Mathieu-py/autonomous-robot/cad/preview/option_b_preview.png

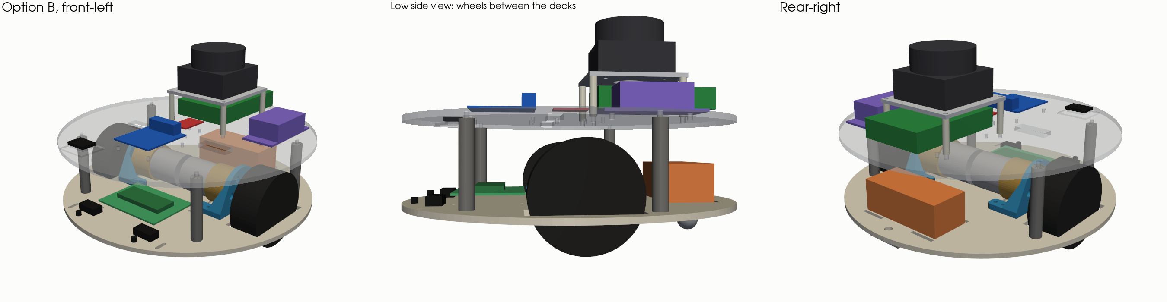
cad/preview/option_b_preview.png
