Mathieu-py/autonomous-robot/cad/preview/motor_mount_right.stl

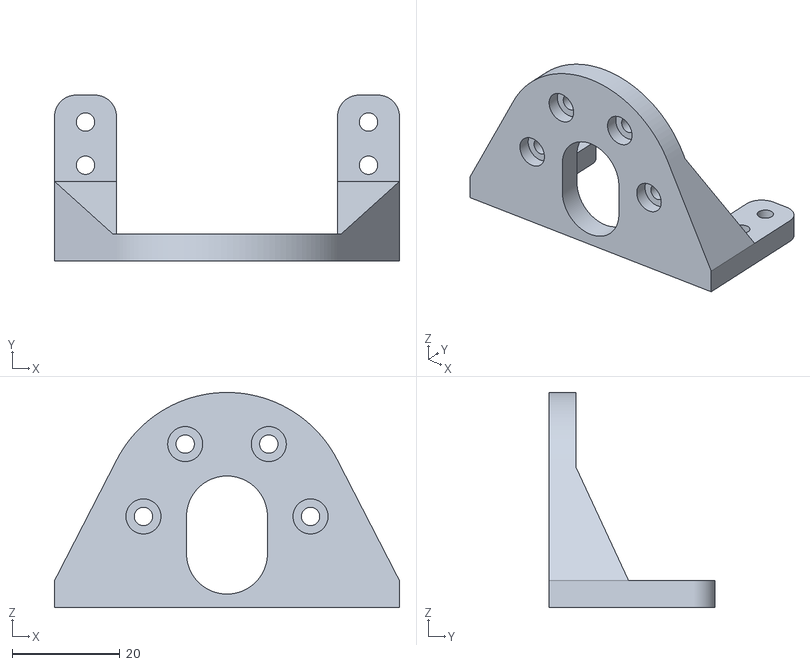
[picture p3: CAD file, 2026-11-11]
cad/preview/motor_mount_right.stl
64.0 x 30.8 x 39.9
