Mathieu-py/autonomous-robot/cad/preview/lower_deck.stl

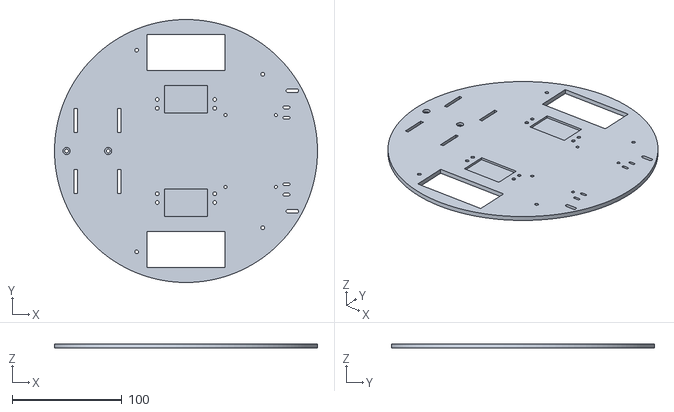
[picture p4: CAD file, 2026-11-11]
cad/preview/lower_deck.stl
240.0 x 239.9 x 4.00
