Mathieu-py/autonomous-robot/(list of files, cad)

Other CAD files:
cad/preview/motor_mount_left.stl
