Mathieu-py/autonomous-robot/results/pid/2026-11-09-run01-no-load-0.5rps-first-gains.csv

t_ms | target | first_speed | first_power | second_speed | second_power
19 | 0.50 | 0.000 | 0.340 | 0.000 | 0.340
39 | 0.50 | 0.182 | 0.295 | 0.162 | 0.302
59 | 0.50 | 0.425 | 0.224 | 0.425 | 0.225
79 | 0.50 | 0.526 | 0.193 | 0.526 | 0.194
99 | 0.50 | 0.566 | 0.179 | 0.546 | 0.186
119 | 0.50 | 0.526 | 0.191 | 0.526 | 0.192
139 | 0.50 | 0.526 | 0.190 | 0.505 | 0.198
159 | 0.50 | 0.526 | 0.189 | 0.526 | 0.191
179 | 0.50 | 0.526 | 0.188 | 0.505 | 0.197
199 | 0.50 | 0.526 | 0.187 | 0.526 | 0.190
219 | 0.50 | 0.526 | 0.187 | 0.505 | 0.196
239 | 0.50 | 0.526 | 0.186 | 0.526 | 0.189
259 | 0.50 | 0.526 | 0.185 | 0.505 | 0.195
279 | 0.50 | 0.526 | 0.184 | 0.526 | 0.188
299 | 0.50 | 0.505 | 0.190 | 0.505 | 0.194
319 | 0.50 | 0.526 | 0.183 | 0.505 | 0.194
339 | 0.50 | 0.526 | 0.183 | 0.526 | 0.187
359 | 0.50 | 0.505 | 0.189 | 0.505 | 0.193
379 | 0.50 | 0.526 | 0.182 | 0.505 | 0.193
399 | 0.50 | 0.526 | 0.181 | 0.526 | 0.186
419 | 0.50 | 0.505 | 0.187 | 0.505 | 0.192
439 | 0.50 | 0.505 | 0.187 | 0.505 | 0.192
459 | 0.50 | 0.526 | 0.180 | 0.526 | 0.185
479 | 0.50 | 0.526 | 0.179 | 0.505 | 0.191
499 | 0.50 | 0.505 | 0.185 | 0.505 | 0.190
519 | 0.50 | 0.505 | 0.185 | 0.505 | 0.190
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
