Mathieu-py/autonomous-robot/results/pid/2026-11-09-run02-fingers-on-0.5rps-first-gains.csv

t_ms | target | first_speed | first_power | second_speed | second_power
13 | 0.50 | 0.000 | 0.340 | 0.000 | 0.340
33 | 0.50 | 0.162 | 0.302 | 0.162 | 0.302
53 | 0.50 | 0.425 | 0.225 | 0.425 | 0.225
73 | 0.50 | 0.526 | 0.194 | 0.526 | 0.194
93 | 0.50 | 0.526 | 0.193 | 0.505 | 0.200
113 | 0.50 | 0.526 | 0.192 | 0.505 | 0.200
133 | 0.50 | 0.526 | 0.192 | 0.505 | 0.200
153 | 0.50 | 0.505 | 0.198 | 0.485 | 0.206
173 | 0.50 | 0.505 | 0.197 | 0.485 | 0.206
193 | 0.50 | 0.505 | 0.197 | 0.485 | 0.207
213 | 0.50 | 0.526 | 0.190 | 0.485 | 0.207
233 | 0.50 | 0.526 | 0.190 | 0.465 | 0.214
253 | 0.50 | 0.505 | 0.195 | 0.485 | 0.209
273 | 0.50 | 0.505 | 0.195 | 0.485 | 0.209
293 | 0.50 | 0.526 | 0.188 | 0.465 | 0.216
313 | 0.50 | 0.505 | 0.194 | 0.485 | 0.211
333 | 0.50 | 0.526 | 0.188 | 0.485 | 0.211
353 | 0.50 | 0.505 | 0.193 | 0.465 | 0.218
373 | 0.50 | 0.505 | 0.193 | 0.465 | 0.219
393 | 0.50 | 0.485 | 0.200 | 0.485 | 0.214
413 | 0.50 | 0.505 | 0.194 | 0.485 | 0.214
433 | 0.50 | 0.526 | 0.187 | 0.465 | 0.221
453 | 0.50 | 0.505 | 0.193 | 0.485 | 0.216
473 | 0.50 | 0.505 | 0.192 | 0.465 | 0.223
493 | 0.50 | 0.505 | 0.192 | 0.485 | 0.217
513 | 0.50 | 0.526 | 0.186 | 0.465 | 0.224
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
