Mathieu-py/autonomous-robot/results/pid/2026-11-09-run03-no-load-1.0rps-higher-ki.csv

t_ms | target | first_speed | first_power | second_speed | second_power
16 | 1.00 | 0.000 | 0.710 | 0.000 | 0.710
36 | 1.00 | 0.202 | 0.697 | 0.222 | 0.690
56 | 1.00 | 0.586 | 0.607 | 0.566 | 0.613
76 | 1.00 | 0.890 | 0.522 | 0.869 | 0.530
96 | 1.00 | 1.072 | 0.464 | 1.092 | 0.457
116 | 1.00 | 1.173 | 0.423 | 1.152 | 0.430
136 | 1.00 | 1.193 | 0.405 | 1.152 | 0.421
156 | 1.00 | 1.173 | 0.401 | 1.173 | 0.405
176 | 1.00 | 1.173 | 0.391 | 1.173 | 0.394
196 | 1.00 | 1.132 | 0.395 | 1.132 | 0.398
216 | 1.00 | 1.152 | 0.380 | 1.112 | 0.398
236 | 1.00 | 1.112 | 0.385 | 1.112 | 0.391
256 | 1.00 | 1.112 | 0.378 | 1.112 | 0.384
276 | 1.00 | 1.092 | 0.379 | 1.092 | 0.385
296 | 1.00 | 1.092 | 0.373 | 1.072 | 0.387
316 | 1.00 | 1.072 | 0.375 | 1.072 | 0.382
336 | 1.00 | 1.072 | 0.371 | 1.072 | 0.378
356 | 1.00 | 1.051 | 0.374 | 1.051 | 0.381
376 | 1.00 | 1.072 | 0.363 | 1.051 | 0.378
396 | 1.00 | 1.051 | 0.366 | 1.051 | 0.375
416 | 1.00 | 1.051 | 0.363 | 1.051 | 0.372
436 | 1.00 | 1.031 | 0.367 | 1.031 | 0.376
456 | 1.00 | 1.031 | 0.366 | 1.031 | 0.374
476 | 1.00 | 1.051 | 0.356 | 1.051 | 0.365
496 | 1.00 | 1.031 | 0.361 | 1.011 | 0.376
516 | 1.00 | 1.011 | 0.366 | 1.031 | 0.369
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
