Mathieu-py/autonomous-robot/results/pid/2026-11-09-run04-no-load-1.0rps-ramp.csv

t_ms | target | first_speed | first_power | second_speed | second_power
3 | 0.100 | 0.000 | 0.071 | 0.000 | 0.071
23 | 0.200 | 0.040 | 0.133 | 0.020 | 0.141
43 | 0.300 | 0.101 | 0.192 | 0.101 | 0.193
63 | 0.400 | 0.243 | 0.224 | 0.202 | 0.240
83 | 0.500 | 0.344 | 0.268 | 0.323 | 0.279
103 | 0.600 | 0.465 | 0.305 | 0.445 | 0.317
123 | 0.700 | 0.586 | 0.340 | 0.566 | 0.354
143 | 0.800 | 0.687 | 0.382 | 0.687 | 0.389
163 | 0.900 | 0.809 | 0.416 | 0.809 | 0.423
183 | 1.000 | 0.910 | 0.456 | 0.910 | 0.463
203 | 1.000 | 1.011 | 0.425 | 1.011 | 0.432
223 | 1.000 | 1.092 | 0.395 | 1.092 | 0.402
243 | 1.000 | 1.112 | 0.382 | 1.092 | 0.397
263 | 1.000 | 1.092 | 0.383 | 1.112 | 0.384
283 | 1.000 | 1.112 | 0.370 | 1.092 | 0.385
303 | 1.000 | 1.072 | 0.378 | 1.092 | 0.379
323 | 1.000 | 1.092 | 0.366 | 1.092 | 0.374
343 | 1.000 | 1.072 | 0.368 | 1.072 | 0.375
363 | 1.000 | 1.051 | 0.371 | 1.072 | 0.371
383 | 1.000 | 1.051 | 0.368 | 1.051 | 0.374
403 | 1.000 | 1.051 | 0.365 | 1.051 | 0.371
423 | 1.000 | 1.051 | 0.362 | 1.031 | 0.375
443 | 1.000 | 1.051 | 0.359 | 1.051 | 0.366
463 | 1.000 | 1.031 | 0.363 | 1.031 | 0.370
483 | 1.000 | 1.031 | 0.361 | 1.031 | 0.368
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
