Mathieu-py/autonomous-robot/results/pid/2026-11-09-run05-no-load-1.0rps-accel-feedforward.csv

t_ms | target | first_speed | first_power | second_speed | second_power
19 | 0.100 | 0.000 | 0.196 | 0.000 | 0.196
39 | 0.200 | 0.101 | 0.237 | 0.101 | 0.237
59 | 0.300 | 0.283 | 0.248 | 0.263 | 0.255
79 | 0.400 | 0.404 | 0.276 | 0.404 | 0.278
99 | 0.500 | 0.546 | 0.296 | 0.505 | 0.312
119 | 0.600 | 0.627 | 0.335 | 0.607 | 0.346
139 | 0.700 | 0.708 | 0.376 | 0.708 | 0.380
159 | 0.800 | 0.809 | 0.410 | 0.809 | 0.415
179 | 0.900 | 0.930 | 0.437 | 0.890 | 0.456
199 | 1.000 | 0.991 | 0.484 | 1.011 | 0.484
219 | 1.000 | 1.112 | 0.316 | 1.092 | 0.329
239 | 1.000 | 1.112 | 0.309 | 1.112 | 0.316
259 | 1.000 | 1.051 | 0.324 | 1.051 | 0.331
279 | 1.000 | 1.011 | 0.336 | 0.991 | 0.350
299 | 1.000 | 0.991 | 0.342 | 0.991 | 0.351
319 | 1.000 | 0.970 | 0.350 | 0.991 | 0.351
339 | 1.000 | 0.970 | 0.352 | 0.970 | 0.359
359 | 1.000 | 0.991 | 0.346 | 0.991 | 0.354
379 | 1.000 | 0.991 | 0.347 | 0.970 | 0.361
399 | 1.000 | 0.991 | 0.348 | 0.991 | 0.356
419 | 1.000 | 0.991 | 0.348 | 0.991 | 0.357
439 | 1.000 | 0.991 | 0.349 | 0.991 | 0.357
459 | 1.000 | 0.991 | 0.349 | 1.011 | 0.350
479 | 1.000 | 0.991 | 0.350 | 0.991 | 0.357
499 | 1.000 | 0.991 | 0.350 | 0.991 | 0.358
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
