Mathieu-py/autonomous-robot/results/pid/2026-11-09-run06-no-load-1.0rps-measured-gains.csv

t_ms | target | first_speed | first_power | second_speed | second_power
13 | 0.100 | 0.000 | 0.172 | 0.000 | 0.169
33 | 0.200 | 0.081 | 0.225 | 0.081 | 0.222
53 | 0.300 | 0.243 | 0.249 | 0.263 | 0.239
73 | 0.400 | 0.404 | 0.266 | 0.384 | 0.270
93 | 0.500 | 0.505 | 0.299 | 0.505 | 0.298
113 | 0.600 | 0.607 | 0.333 | 0.607 | 0.332
133 | 0.700 | 0.708 | 0.366 | 0.708 | 0.366
153 | 0.800 | 0.789 | 0.407 | 0.789 | 0.407
173 | 0.900 | 0.910 | 0.435 | 0.910 | 0.435
193 | 1.000 | 0.991 | 0.475 | 0.991 | 0.476
213 | 1.000 | 1.092 | 0.350 | 1.092 | 0.353
233 | 1.000 | 1.112 | 0.333 | 1.132 | 0.327
253 | 1.000 | 1.092 | 0.328 | 1.072 | 0.336
273 | 1.000 | 1.031 | 0.341 | 1.011 | 0.351
293 | 1.000 | 1.011 | 0.346 | 1.011 | 0.350
313 | 1.000 | 1.011 | 0.345 | 1.011 | 0.349
333 | 1.000 | 0.991 | 0.351 | 0.991 | 0.355
353 | 1.000 | 0.991 | 0.352 | 1.011 | 0.349
373 | 1.000 | 1.011 | 0.345 | 0.991 | 0.355
393 | 1.000 | 0.991 | 0.352 | 0.991 | 0.356
413 | 1.000 | 0.991 | 0.353 | 1.011 | 0.350
433 | 1.000 | 1.011 | 0.346 | 1.011 | 0.348
453 | 1.000 | 0.991 | 0.353 | 0.991 | 0.355
473 | 1.000 | 1.011 | 0.346 | 1.011 | 0.348
493 | 1.000 | 1.011 | 0.345 | 0.991 | 0.355
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
