Mathieu-py/autonomous-robot/results/pid/2026-11-09-run02-fingers-on-0.5rps-first-gains.png

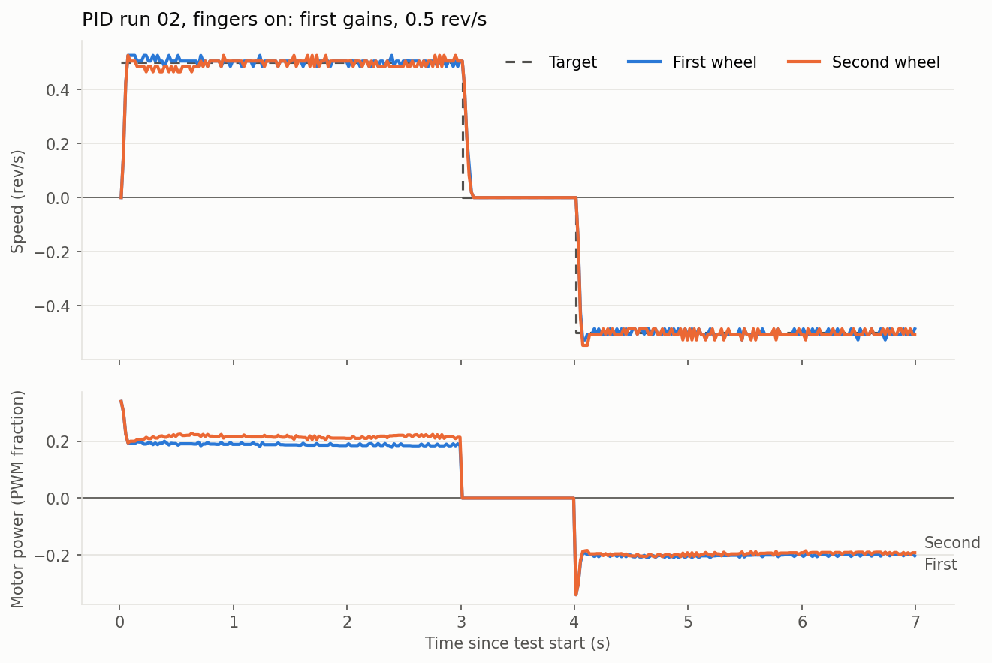
results/pid/2026-11-09-run02-fingers-on-0.5rps-first-gains.png
