Mathieu-py/autonomous-robot/results/pid/2026-11-09-run03-no-load-1.0rps-higher-ki.png

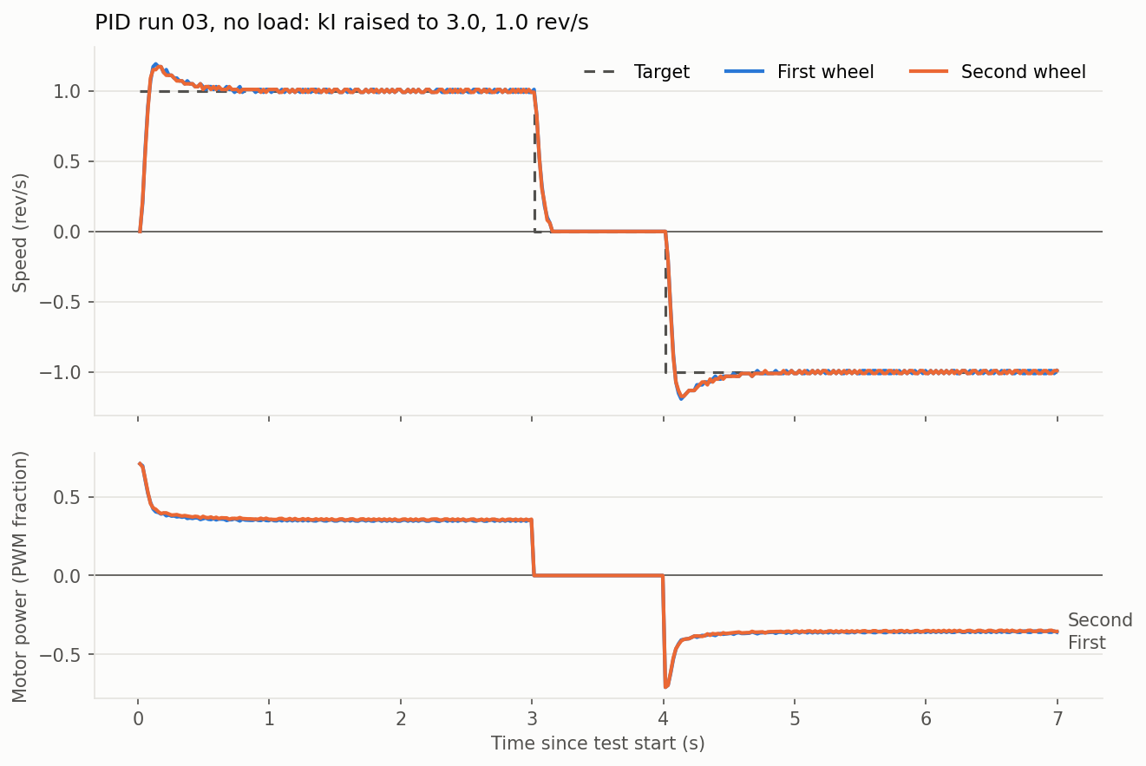
results/pid/2026-11-09-run03-no-load-1.0rps-higher-ki.png
