Mathieu-py/autonomous-robot/results/pid/2026-11-09-run04-no-load-1.0rps-ramp.png

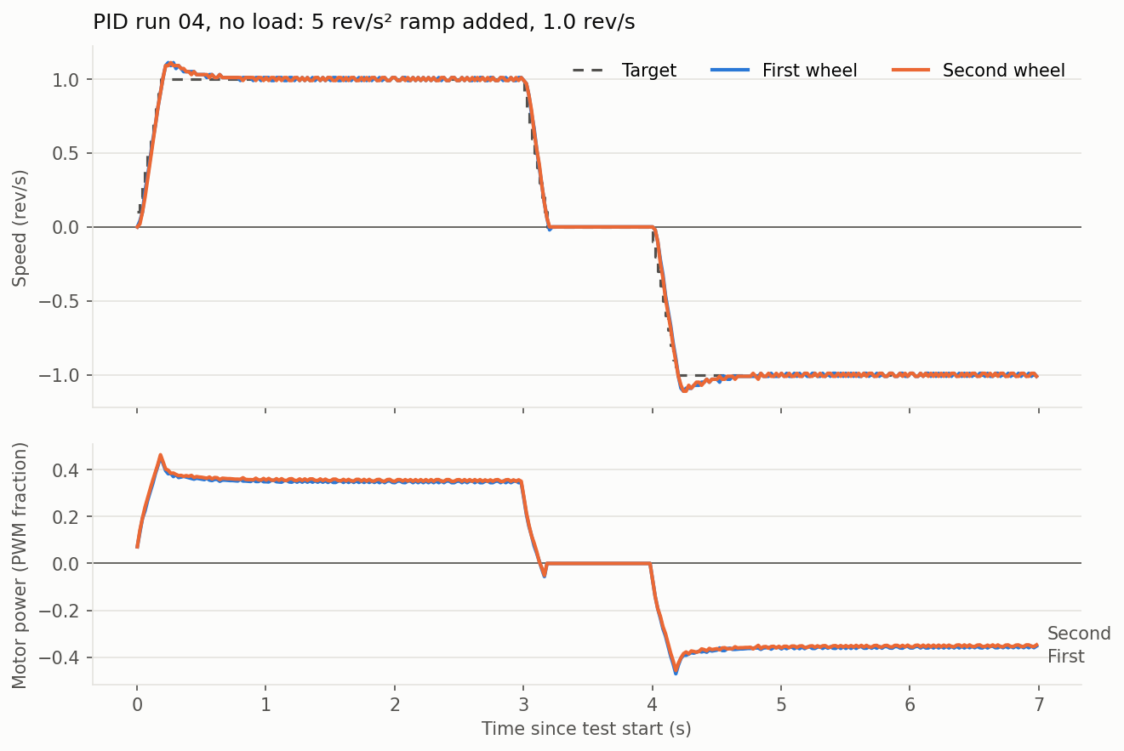
results/pid/2026-11-09-run04-no-load-1.0rps-ramp.png
