Mathieu-py/autonomous-robot/results/pid/2026-11-09-run05-no-load-1.0rps-accel-feedforward.png

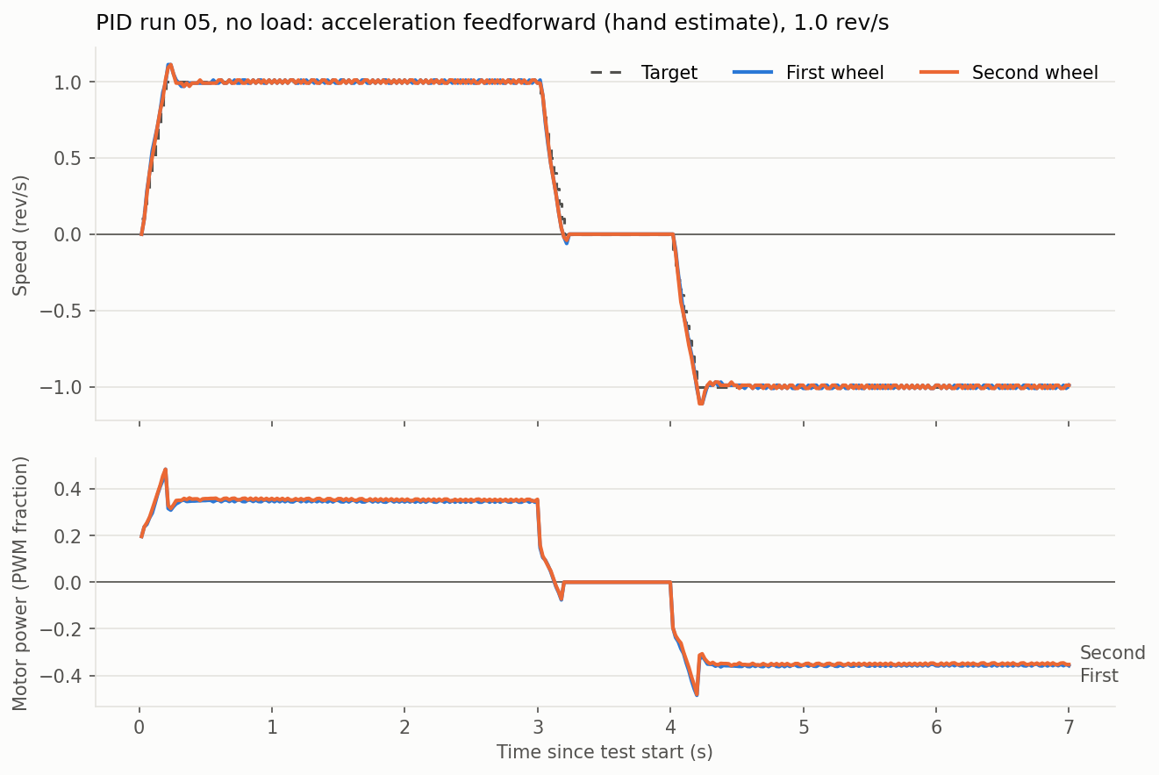
results/pid/2026-11-09-run05-no-load-1.0rps-accel-feedforward.png
