Mathieu-py/autonomous-robot/results/pid/2026-11-09-run06-no-load-1.0rps-measured-gains.png

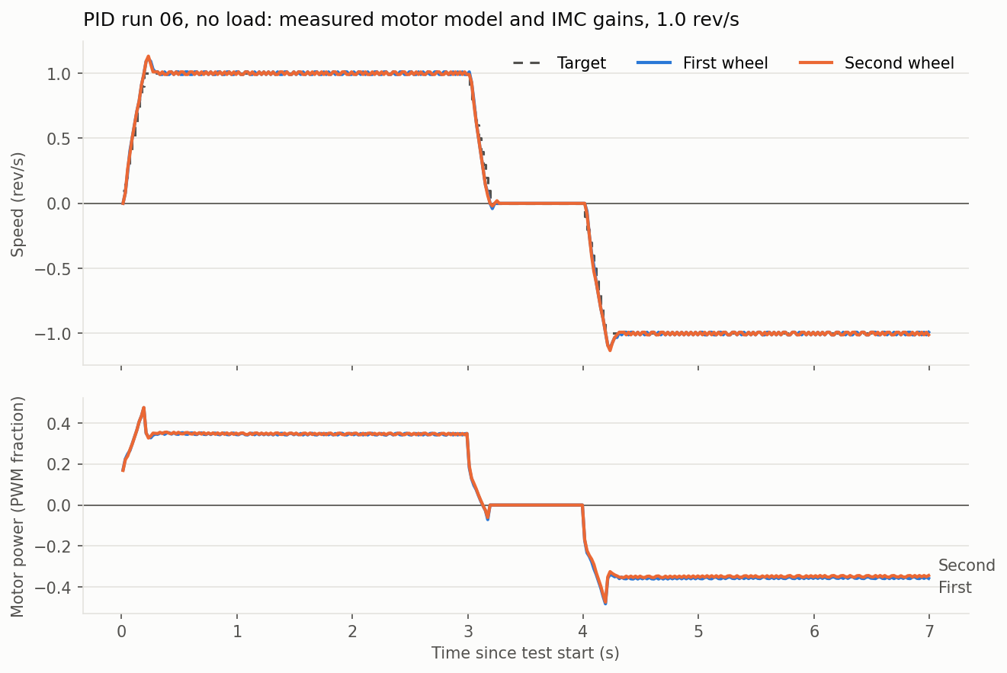
results/pid/2026-11-09-run06-no-load-1.0rps-measured-gains.png
