Mathieu-py/autonomous-robot/results/pid/2026-11-09-run08-fingers-on-1.0rps-aligned-timing.png

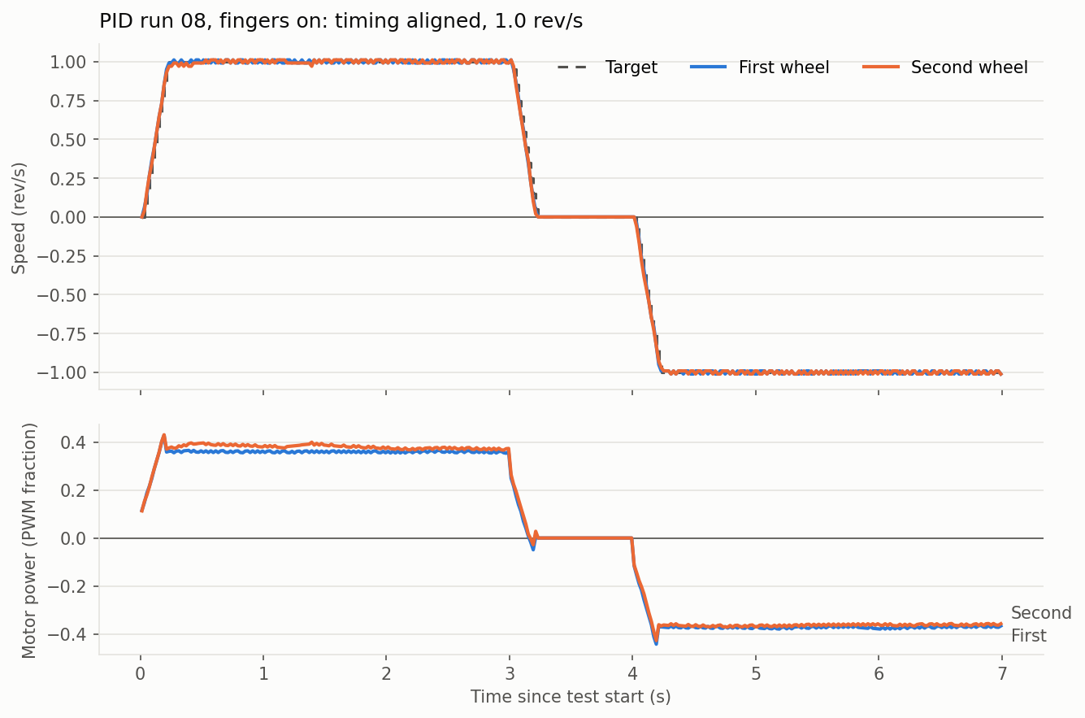
results/pid/2026-11-09-run08-fingers-on-1.0rps-aligned-timing.png
