Mathieu-py/autonomous-robot/results/safety/2026-11-09-run01-no-load-1.0rps-bumpers-and-holds.png

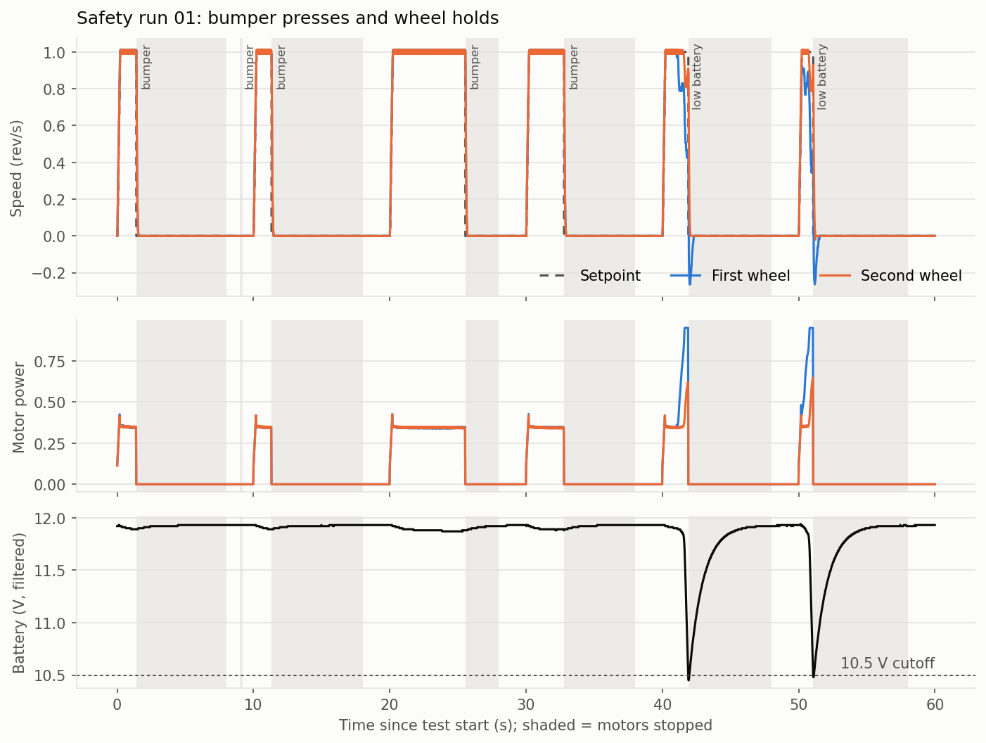
results/safety/2026-11-09-run01-no-load-1.0rps-bumpers-and-holds.png
