Mathieu-py/autonomous-robot/results/safety/2026-11-09-run02-no-load-1.0rps-battery-and-stall.png

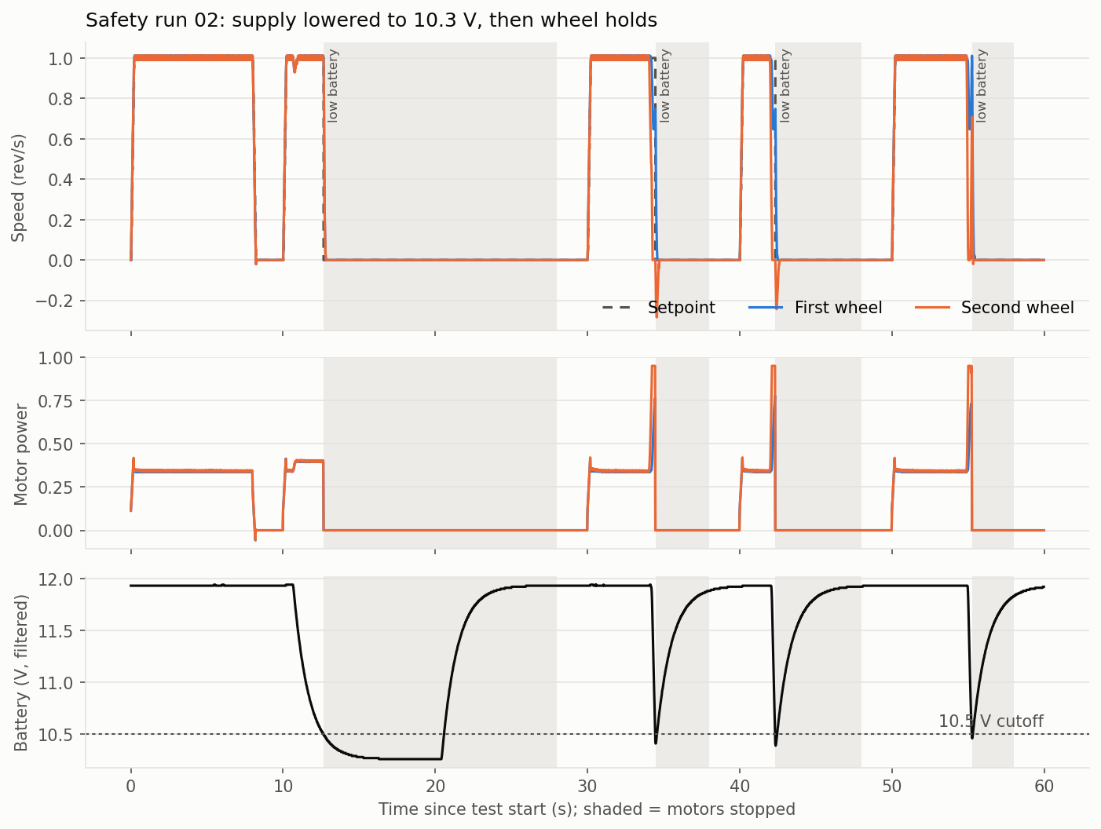
results/safety/2026-11-09-run02-no-load-1.0rps-battery-and-stall.png
