Mathieu-py/autonomous-robot/results/sysid/2026-11-09-run01-no-load-both-motors.png

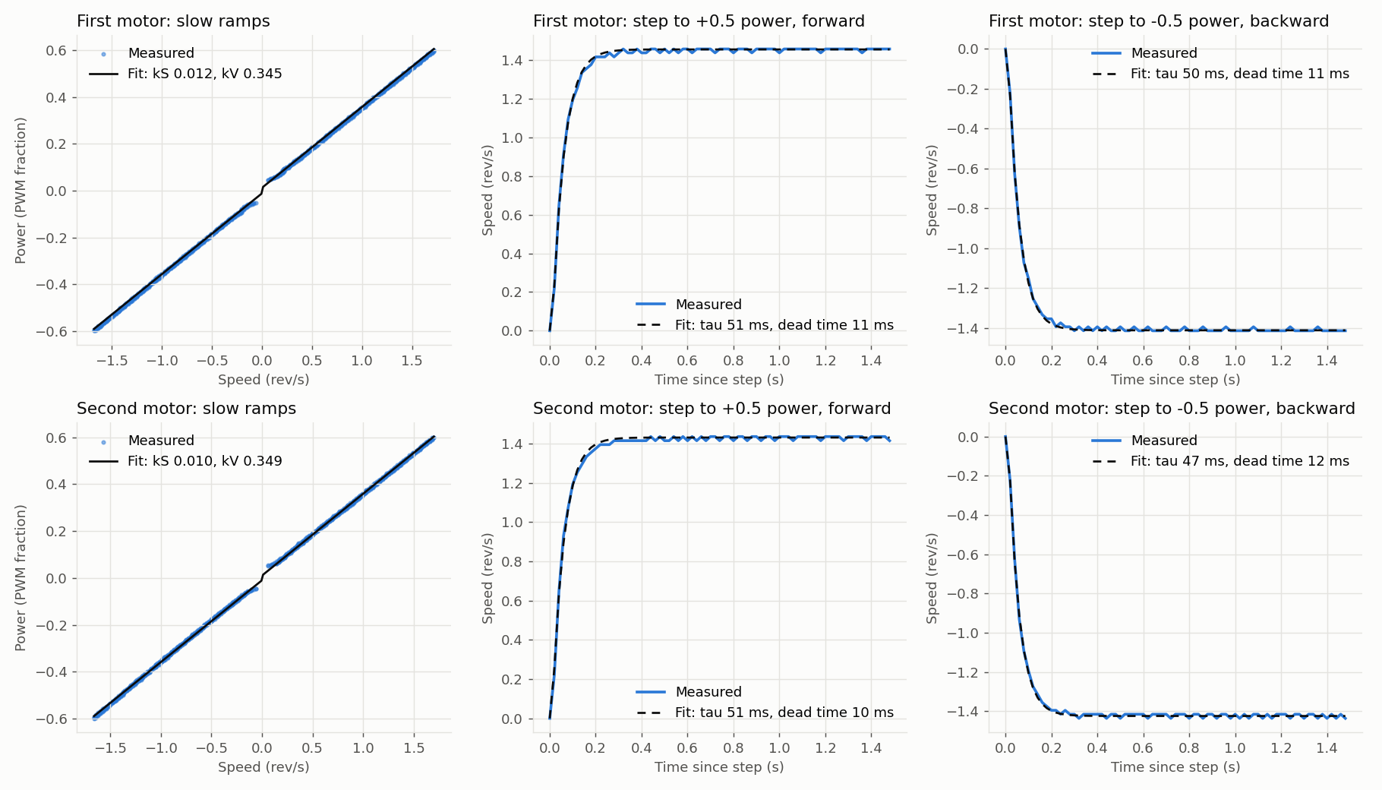
results/sysid/2026-11-09-run01-no-load-both-motors.png
