Mathieu-py/autonomous-robot/results/teleop/2026-11-09-run01-no-load-keyboard.png

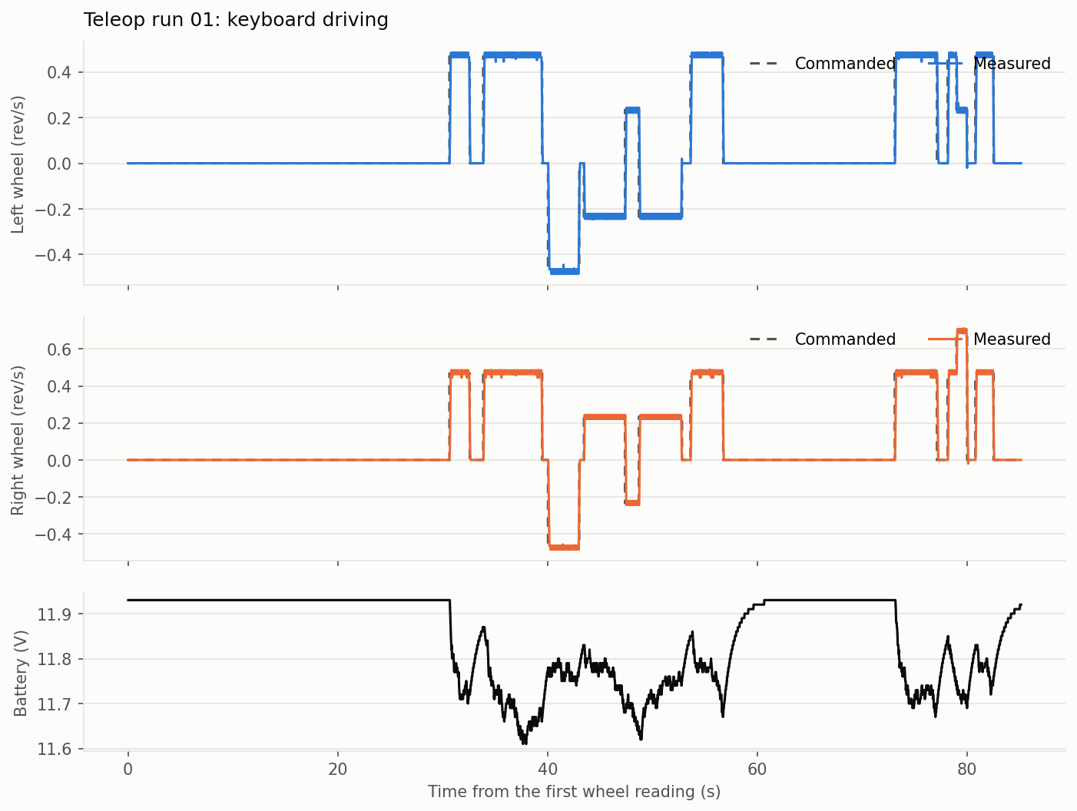
results/teleop/2026-11-09-run01-no-load-keyboard.png
