Mathieu-py/autonomous-robot/results/teleop/2026-11-09-run02-no-load-keyboard-and-bridge-stop.png

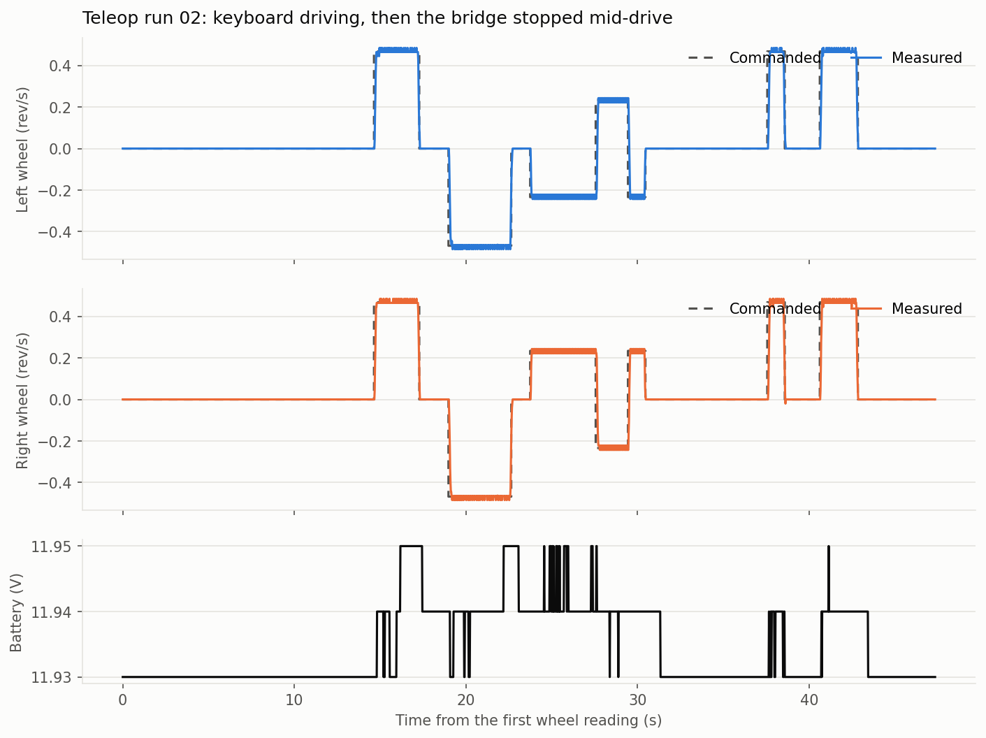
results/teleop/2026-11-09-run02-no-load-keyboard-and-bridge-stop.png
