Mathieu-py/autonomous-robot/results/teleop/2026-11-09-run03-no-load-keyboard-and-bumper.png

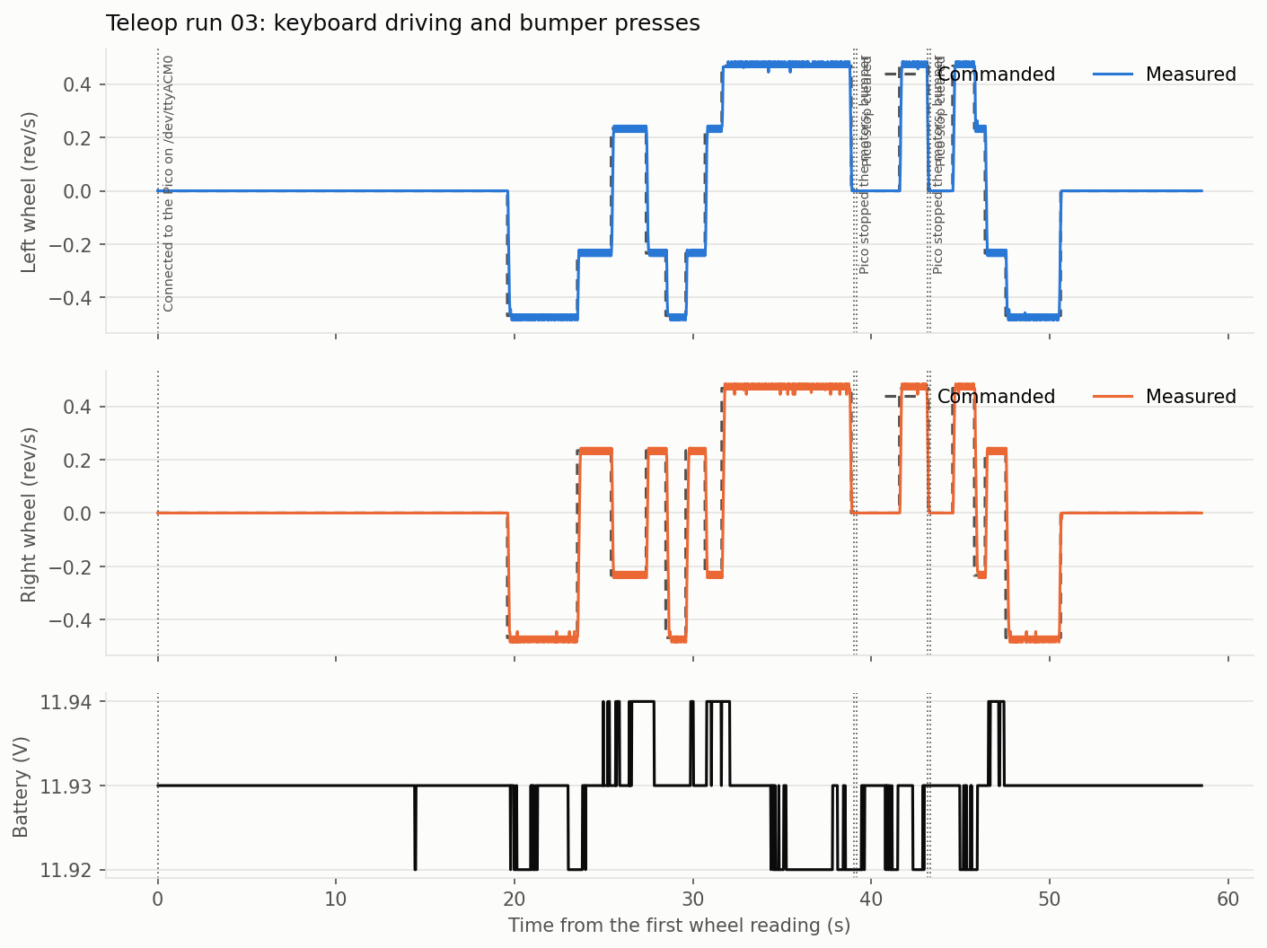
results/teleop/2026-11-09-run03-no-load-keyboard-and-bumper.png
