Mathieu-py/autonomous-robot/results/teleop/2026-11-09-run04-no-load-keyboard-quick-switching.png

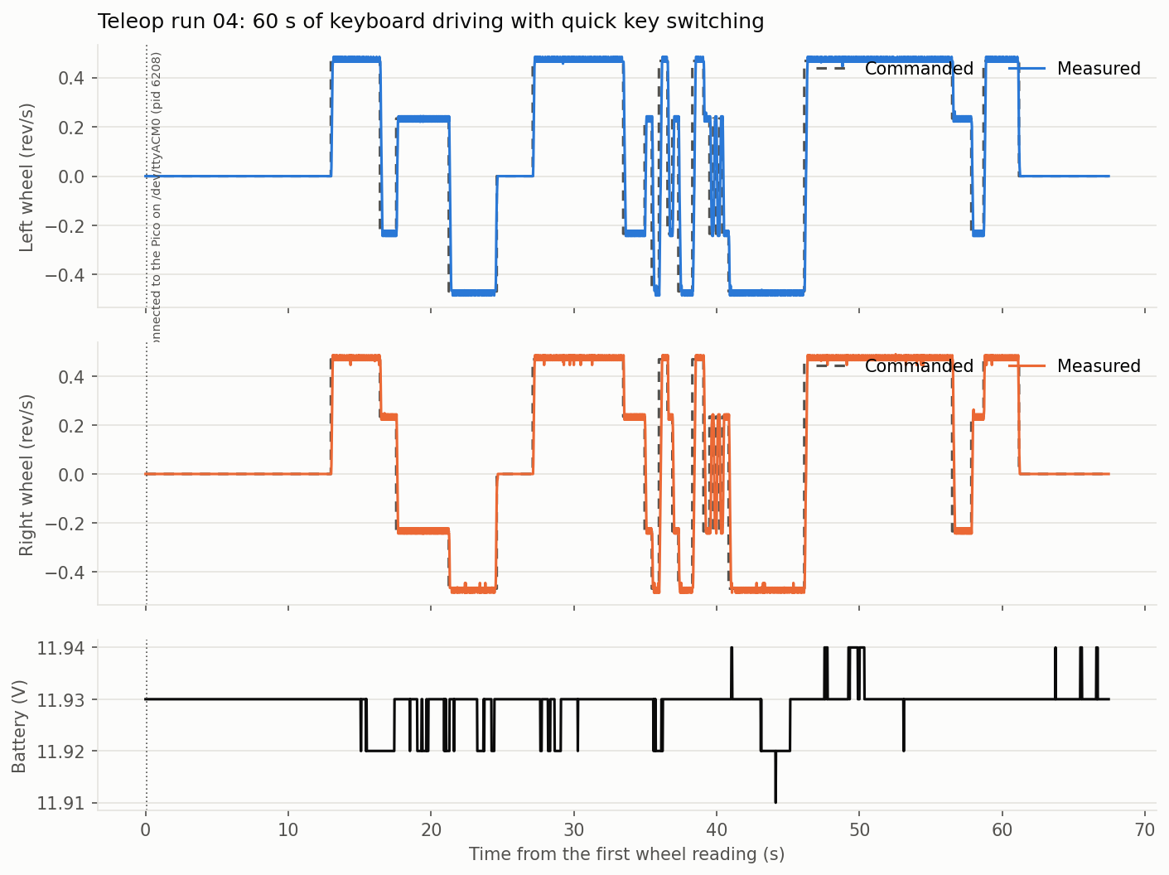
results/teleop/2026-11-09-run04-no-load-keyboard-quick-switching.png
