Mathieu-py/autonomous-robot/ros/pico_bridge/src/pico_bridge_node.cpp

// Sends /cmd_vel to the Pico as wheel speeds, and publishes the wheel states
// and battery voltage the Pico reports.

#include <chrono>
#include <cmath>
#include <memory>
#include <string>

#include "geometry_msgs/msg/twist.hpp"
#include "pico_bridge/drive_protocol.hpp"
#include "pico_bridge/serial_port.hpp"
#include "rclcpp/rclcpp.hpp"
#include "sensor_msgs/msg/battery_state.hpp"
#include "sensor_msgs/msg/joint_state.hpp"

namespace pico_bridge {

constexpr double kRadiansPerRev = 2.0 * M_PI;

template <typename T>
struct LeftRight {
  T left;
  T right;
};

class PicoBridgeNode : public rclcpp::Node {
 public:
  PicoBridgeNode()
      : Node("pico_bridge"),
        port_path_(declare_parameter("port", "/dev/pico")),
        geometry_{declare_parameter("wheel_diameter_m", 0.068),
                  declare_parameter("wheel_separation_m", 0.180)},
        is_left_first_motor_(declare_parameter("left_motor", "first") ==
                             std::string("first")),
        left_sign_(declare_parameter("left_reversed", false) ? -1.0 : 1.0),
        right_sign_(declare_parameter("right_reversed", false) ? -1.0 : 1.0),
        ticks_per_rev_(declare_parameter("ticks_per_rev", 2473.0)),
        cmd_vel_timeout_(rclcpp::Duration::from_seconds(
            declare_parameter("cmd_vel_timeout_s", 1.0))),
        serial_(port_path_),
        last_cmd_vel_time_(now()) {
    cmd_vel_subscription_ = create_subscription<geometry_msgs::msg::Twist>(
        "cmd_vel", 10, [this](const geometry_msgs::msg::Twist& twist) {
          last_cmd_vel_ = twist;
          last_cmd_vel_time_ = now();
        });
    joint_state_publisher_ =
        create_publisher<sensor_msgs::msg::JointState>("joint_states", 10);
    battery_publisher_ =
        create_publisher<sensor_msgs::msg::BatteryState>("battery", 10);
    timer_ = create_wall_timer(std::chrono::milliseconds(20),
                               [this] { exchange_with_pico(); });
    RCLCPP_INFO(get_logger(), "Connected to the Pico on %s",
                port_path_.c_str());
  }

 private:
  // Every 20 ms: send the current command, then handle what the Pico sent.
  void exchange_with_pico() {
    if (!serial_.write_text(command_for_pico()) ||
        !serial_.read_available(received_)) {
      RCLCPP_ERROR_THROTTLE(get_logger(), *get_clock(), 1000,
                            "Lost the serial link to the Pico");
      return;
    }
    size_t line_end;
    while ((line_end = received_.find('\n')) != std::string::npos) {
      const std::string line = received_.substr(0, line_end);
      received_.erase(0, line_end + 1);
      if (const auto status = parse_status_line(line)) {
        publish_status(*status);
      } else if (!line.empty() && line != "\r") {
        // Anything else from the Pico is a one-off message, e.g. a low-battery
        // shutdown request or a watchdog reboot.
        RCLCPP_WARN(get_logger(), "Pico: %s", line.c_str());
      }
    }
  }

  std::string command_for_pico() const {
    const bool is_cmd_vel_fresh =
        now() - last_cmd_vel_time_ <= cmd_vel_timeout_;
    const geometry_msgs::msg::Twist twist =
        is_cmd_vel_fresh ? last_cmd_vel_ : geometry_msgs::msg::Twist();
    const WheelRps wheels =
        wheel_rps_from_twist(twist.linear.x, twist.angular.z, geometry_);
    const double left = wheels.left * left_sign_;
    const double right = wheels.right * right_sign_;
    return is_left_first_motor_ ? format_command(left, right)
                                : format_command(right, left);
  }

  // Maps the Pico's first/second motor values onto the left/right wheels.
  template <typename T>
  LeftRight<T> to_left_right(T first, T second) const {
    return is_left_first_motor_ ? LeftRight<T>{first, second}
                                : LeftRight<T>{second, first};
  }

  void publish_status(const PicoStatus& status) {
    const auto counts = to_left_right(status.first_count, status.second_count);
    const auto rps = to_left_right(status.first_rps, status.second_rps);

    sensor_msgs::msg::JointState joints;
    joints.header.stamp = now();
    joints.name = {"left_wheel_joint", "right_wheel_joint"};
    joints.position = {
        left_sign_ * counts.left / ticks_per_rev_ * kRadiansPerRev,
        right_sign_ * counts.right / ticks_per_rev_ * kRadiansPerRev};
    joints.velocity = {left_sign_ * rps.left * kRadiansPerRev,
                       right_sign_ * rps.right * kRadiansPerRev};
    joint_state_publisher_->publish(joints);

    sensor_msgs::msg::BatteryState battery;
    battery.header.stamp = joints.header.stamp;
    battery.voltage = static_cast<float>(status.battery_volts);
    battery.present = true;
    battery_publisher_->publish(battery);

    if (status.stop_reason != last_stop_reason_) {
      if (status.stop_reason == "none") {
        RCLCPP_INFO(get_logger(), "Pico stop cleared");
      } else {
        RCLCPP_WARN(get_logger(), "Pico stopped the motors: %s",
                    status.stop_reason.c_str());
      }
      last_stop_reason_ = status.stop_reason;
    }
  }

  std::string port_path_;
  DriveGeometry geometry_;
  bool is_left_first_motor_;
  double left_sign_;
  double right_sign_;
  double ticks_per_rev_;
  rclcpp::Duration cmd_vel_timeout_;
  SerialPort serial_;
  std::string received_;
  std::string last_stop_reason_ = "none";

  geometry_msgs::msg::Twist last_cmd_vel_;
  rclcpp::Time last_cmd_vel_time_;
  rclcpp::Subscription<geometry_msgs::msg::Twist>::SharedPtr
      cmd_vel_subscription_;
  rclcpp::Publisher<sensor_msgs::msg::JointState>::SharedPtr
      joint_state_publisher_;
  rclcpp::Publisher<sensor_msgs::msg::BatteryState>::SharedPtr
      battery_publisher_;
  rclcpp::TimerBase::SharedPtr timer_;
};

}  // namespace pico_bridge

int main(int argc, char** argv) {
  rclcpp::init(argc, argv);
  rclcpp::spin(std::make_shared<pico_bridge::PicoBridgeNode>());
  rclcpp::shutdown();
  return 0;
}
