Mathieu-py/autonomous-robot/(commit log)

2026-10-15 Add budget parts list and update build plan budget
    Exact parts, links and compatibility checks for a ~CAD $590 build,
    down from ~$930. Ignore browser logs left by research tooling.
2026-11-04 Update docs: parts received, simulation setup working
    Record the working WSL2, ROS 2 and Gazebo setup, including the GPU
    settings this laptop needs. Rewrite the bench tests with the no-solder
    converter test and the correct bench supply, replace pre-order notes
    with order status, and add a README.
2026-11-06 Final parts ordered, MPU solder done
2026-11-09 First motor run forward and backwards with firmware script
2026-11-09 Dual motors running, revs/s calculated
2026-11-09 PID loop imeplemented, motor tests 1-9, refactor, and tools for motor specific values
    [2026-11-09-run01-no-load-0.5rps-first-gains.csv, 2026-11-09-run01-no-load-both-motors.csv, 2026-11-09-run02-fingers-on-0.5rps-first-gains.csv, 2026-11-09-run03-no-load-1.0rps-higher-ki.csv, 2026-11-09-run04-no-load-1.0rps-ramp.csv, 2026-11-09-run05-no-load-1.0rps-accel-feedforward.csv, 2026-11-09-run06-no-load-1.0rps-measured-gains.csv, 2026-11-09-run07-no-load-1.0rps-aligned-timing.csv]
2026-11-09 Hardware run to confirm working condirion before safety implementation
    [2026-11-09-run10-no-load-1.0rps-naming-and-format-check.csv]
2026-11-09 Firmware final test, added stop bumper function
    [2026-11-09-run01-no-load-1.0rps-bumpers-and-holds.csv, 2026-11-09-run02-no-load-1.0rps-battery-and-stall.csv]
2026-11-10 Main split, drive commands
    [2026-11-09-run01-no-load-keyboard.csv, 2026-11-09-run02-no-load-keyboard-and-bridge-stop.csv, 2026-11-09-run03-no-load-keyboard-and-bumper.csv, 2026-11-09-run04-no-load-keyboard-quick-switching.csv]
2026-11-10 Pico and Pi wifi connection testing completed
2026-11-11 First robot design + stl for 3d print for lower deck and motor brackets
    [lower_deck.stl, motor_mount_left.stl, motor_mount_right.stl]
